dr-paradox-design/analog_neuron/docs/gate-A.md

# Gate A — schematic sign-off (2026-10-15)

**Result: PASS.** Every target spec is met at schematic level over all 45 PVT points
(5 process corners × −40 / 27 / 125 °C × 1.62 / 1.8 / 1.98 V). Layout may start.

Design: `spice/neuron/neuron_core.spice` (with `vi_conv.spice`, `ota5p.spice`,
`spice/bias/bias_ref.spice`). Evidence tables: `verif/sim/gate-A/`. Each one is the console
output of `scripts/sim.py`, regenerated by the command in the last column.

| Spec (CLAUDE.md) | Target | Result | Evidence | Command |
|---|---|---|---|---|
| Input range | 0.3 – 1.2 V | transfer verified over 0.3 – 1.2 V | `neuron_pvt.txt` | `scripts/sim.py spice/neuron/neuron_tb.cir --pvt --jobs 14` |
| Unit bias current | 1 – 5 µA | 1.13 – 3.89 µA (incl. R ±20 %) | `bias_pvt.txt` | `scripts/sim.py spice/bias/bias_tb.cir --pvt` |
| Bias start-up | every corner | 1 µs / 100 µs / quasi-static ramps and brown-out all settle to the same current (45/45) | `bias_startup_pvt.txt`, `bias_dcramp_pvt.txt` | `…/bias_startup_tb.cir --pvt`, `…/bias_dcramp_tb.cir --pvt` |
| Total power | < 100 µW | 37.7 – 78.3 µW; 98.2 µW worst at R −20 % (see note) | `neuron_pvt.txt`, `neuron_pvt_r_minus20.txt` | as above |
| MAC linearity | ≤ 5 % | INL ≤ 0.71 % (PVT), ≤ 0.76 % (R ±20 %), ≤ 0.82 % (MC) | `neuron_pvt*.txt`, `neuron_mc200.txt` | as above |
| Corners | TT/FF/SS/SF/FS, −40…125 °C, VDD ±10 % | 45/45 clean for every testbench | all | — |
| Mismatch: weight σ | < 2 – 3 % | slope σ 1.47 % (200 runs, tt_mm) | `neuron_mc200.txt` | `scripts/sim.py spice/neuron/neuron_tb.cir --mc 200 --corner tt_mm --jobs 14` |
| Stability (internal) | PM ≥ 60° | ≥ 71.7° at 45 PVT × 3 input levels | `vi_stab_pvt.txt` | `scripts/sim.py spice/neuron/vi_stab_tb.cir --pvt --jobs 12` |
| Area | 180 × 115 µm | ≈ 6.2k µm² of devices → ≈ 12–14k µm² with routing (estimate) | `docs/neuron-core.md` | `build/area/gen_all.tcl` |

Function delivered: **y = 2 · max(0, x − V_k)**, V_k = 0.326 · VDD (0.586 V at 1.8 V).
Slope over PVT 1.903 – 1.995; knee independent of temperature and process.

## Decisions taken at this gate

- **Output: raw node, no buffer.** Silicluster has not specified the output load. y has
  ≈ 300 kΩ output impedance and must be measured with ≥ 10 MΩ (≈ 2.8 % gain loss; linearity is
  unaffected). If Silicluster later specifies a heavier load, a buffer needs a core power cut first.
- **Core power kept as verified.** The 98.2 µW case combines the hottest, highest-supply corner
  with an assumed −20 % xhigh_po sheet resistance; SkyWater lists xhigh_po e-test specs as TBD.

## Carried into layout

- Mirror matching sets the weight σ: MF / XWS / XWK in common-centroid with dummies.
- R_in, R_k, R_out from interdigitated unit segments (also required by the 115 µm height).
- Cc MIM capacitors (metal 3–4) need gaps in the M4 power grid.
- Post-layout: re-check phase margin with extracted parasitics (pre-layout margin 71.7°).
- Simulation pitfall: the xhigh_po model allows spurious kV solutions; `neuron_tb.cir` detects
  and retries them automatically (see `docs/neuron-core.md`).
