dr-paradox-design/analog_neuron/docs/img/block-diagram-philosophy.md

# Conductive Silence

*A visual philosophy for drawings of things that flow but cannot be seen.*

Conductive Silence treats the invisible as something that can be counted. A flow is never a single
arrow; it is a bundle of hairlines laid side by side, and the number of strands is the quantity.
When a flow is amplified, the bundle visibly thickens strand by strand; when two flows meet and
cancel, strands end. Meaning is carried by accumulation and subtraction of identical marks, drawn
with the patience of an engraver: each line the same weight, each gap the same width, the whole
reading as one calm texture from afar and as an exact ledger up close. Nothing is exaggerated to be
understood — the drawing rewards the viewer who slows down.

Space is a dark, quiet field, deep enough that a hairline glows. Forms are few and perfect: true
circles for points where things meet, softened rectangles for places where something transforms, and
nothing ornamental between them. Elements align to an unseen grid of strict horizontals; diagonals
appear only where flows must converge, and then as long, unhurried curves. Generous negative space
is structural, not leftover — it isolates each event so the eye moves through the plate in the order
the flow does. The composition must feel meticulously crafted, every spacing resolved by countless
small corrections until nothing can move.

Colour is a code, not a mood. A neutral grey carries structure; two or three restrained accents —
cool blue, warm amber, quiet green — identify distinct flows and never mix. Saturation stays low so
that the accents read as light on dark rather than paint. Where flows meet, colour does not blend;
one simply ends and another begins, so the palette itself states what is conserved and what is
consumed. The calibration of these few hues should look like the product of deep expertise:
balanced against each other and against the darkness with painstaking attention.

Inside each form sits a miniature: a row of identical ticks for repeated units, a small glyph for a
behaviour, a ratio expressed as stacked segments. These are the plate's quiet evidence — tiny,
exact, and only legible to those who look closely. Scale moves in deliberate steps: the field, the
flows, the forms, the miniatures, and finally the text, each an order of magnitude finer than the
last.

Typography is clinical and sparse. Labels are thin, uppercase and widely tracked, set small beneath
the forms they name; indices and coordinates are monospaced and smaller still, like the margins of a
scientific plate. One single phrase — a law, an equation, a name — may be set larger in a refined
serif italic as the plate's anchor. Text never explains; it only names what the drawing already
shows. Margins are generous and every element stands clear of every other. The finished plate should
read as master-level execution: an artifact from an imaginary discipline that has spent a lifetime
learning to draw silence carrying current.
