dr-paradox-design/analog_neuron/docs/img/transfer.png

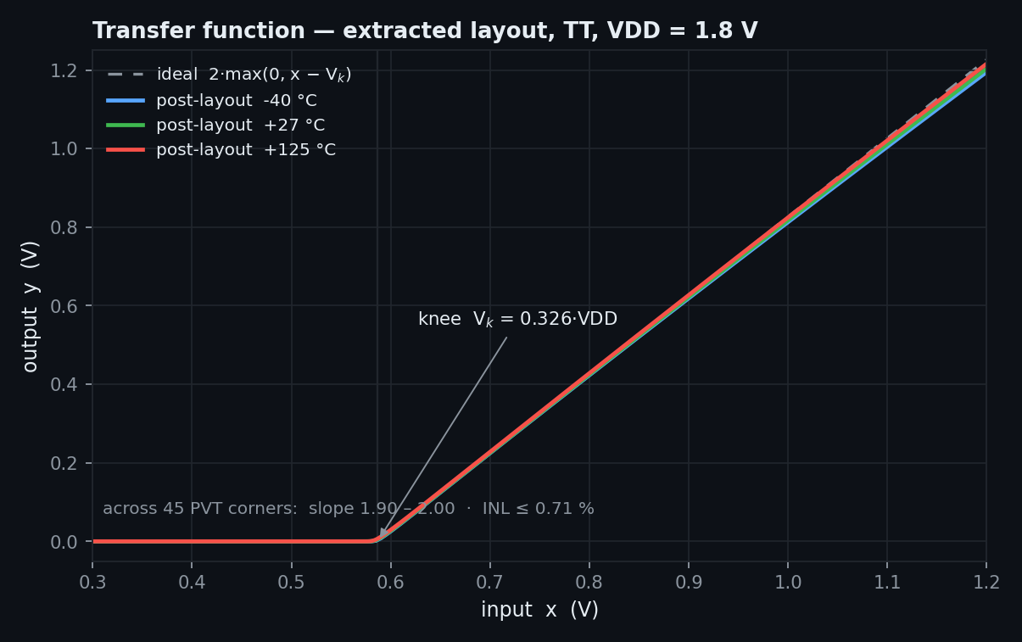
docs/img/transfer.png
