dr-paradox-design/analog_neuron/(commit log)

2026-10-11 Add device characterisation testbench (Vgs, gm/Id vs L)
    nfet/pfet_01v8 at W=2um, |Vds|=0.9V, L sweep 0.5-8um; templated
    for corner/temp/VDD via scripts/sim.py.
2026-10-11 Bias reference: device characterisation and beta-multiplier with start-up
    - spice/char/devchar_tb.cir: nfet/pfet_01v8 Vgs and gm/Id vs L at 1/2/5 uA
    - spice/bias/bias_ref.spice: beta-multiplier (K=4, xhigh_po R) + start-up
    - start-up fixed: weaker pull-up and stronger MS2 so MS3 turns fully off
    - R sweep and operating-point debug testbenches
2026-10-11 Bias reference: fix false low-current state, add PVT testbench
    - MS3 start-up kick now injects VDD -> VN: at -40 C / 1.62 V the PMOS gate
    line VP drops below VN, so the old VP -> VN kick conducted backwards and
    held the loop at ~0.3 uA
    - weaker pull-up (2 x L=40) and stronger MS2 (W=16) so ST < 10 mV everywhere
    - bias_tb.cir: 45-point PVT with R nominal/-20%/+20% (PDK corners do not
    vary xhigh_po sheet resistance)
    - sim.py: --corners option for custom corner lists (e.g. ss_hh)
    - result: 1.13-3.89 uA over PVT and R+-20%, start-up fully off
2026-10-11 Docs: bias reference design note, ADR findings; add start-up testbench
    - docs/bias-reference.md: circuit, sizing, design choices, PVT results
    - ADR-001: findings (pfet Vt headroom, xhigh_po not in R corners, sf/fs
    naming, weak-inversion bias, start-up false state, PTAT bias term) and
    new open question on threshold accuracy over temperature
    - spice/bias/bias_startup_tb.cir: 1 us / 100 us / 5 ms ramps + brown-out
2026-10-11 OTA: 5T PMOS-input OTA for the V->I converters; ADR records owner decisions
    - spice/neuron/ota5p.spice: PMOS pair in its own n-well (tied to tail),
    NMOS mirror load, tail = PMOS copy of the bias reference
    - ota5p_tb.cir: open-loop AC at 0.25 V input CM: ~38 dB, UGF 5.2 MHz into
    0.5 pF, ~87 deg phase margin, systematic offset ~3.5 mV (5 corners)
    - ADR-001: accepted; owner decisions (ReLU, w=2 with knee at ~0.6 V, ~200k
    input impedance OK, VDD-divider reference) and refined knee-replica
    signal path
2026-10-11 Bias start-up verified at 45 PVT points; V->I converter with compensation
    Bias reference start-up (all 45 PVT points, 5 profiles each):
    - 1 us ramp, 100 us ramp, brown-out to 0.8 V, quasi-static DC up/down
    all settle to the same current (0.000 % spread); start < 3 us,
    turn-on at VDD 0.91-1.22 V, ST <= 7.4 mV
    - 5 ms transient ramp replaced by a DC sweep: ngspice stalls on the
    femtoamp start-up nodes while every device is still off
    V->I converter (OTA + R_in + MF, I0 = Iref/2 keeps MF out of deep
    subthreshold):
    - Miller Cc 0.45 pF + nulling Rz ~49k: phase margin 79-109 deg at TT
    (was 15 deg at x = 0.3 V with 0.2 pF and no Rz)
    - DC: endpoint INL <= 0.054 % over 0.3-1.2 V at all 5 corne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
2026-10-11 Neuron core: knee-replica ReLU neuron, y = 2(R_out/R_in) max(0, x - V_k)
    - neuron_core.spice: bias ref, xhigh_po unit-resistor divider (Ra:Rb:Rc:R_k
    = 9:4:3:7 -> VREF 0.142 VDD, VK 0.331 VDD), signal + knee V->I
    converters, x2 NMOS weight mirrors, PMOS knee flip, PMOS ReLU diode and
    output copy into R_out (7 units)
    - divider fix: R_k current returns to VSS through MF_k, not into VREF
    - neuron_tb.cir: x ramp 0.29->1.21 V over 2 ms (DC sweep in x needed
    repeated gmin rescues); 5 corners @27C/1.8V: INL 0.38-0.42 %, error vs
    ideal <= 2.2 %, slope 1.96-1.97, knee 0.582 V, peak 55.6 uW, y < 1 uV
    below the knee
    - V->I loop stability, variant D (0.45 pF + ~49k Rz, I0 = Iref/2): phase
    m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
2026-10-11 Monte Carlo support; robust neuron testbench (WIP: MC outliers open)
    sim.py:
    - --mc N (seeds 1..N via @SEED@, use a *_mm corner) and --jobs N
    (parallel ngspice, one thread each); prints mean/sigma per result
    - a testbench result 'sane = 0' marks the run as failed
    neuron_tb.cir:
    - the PDK xhigh_po model has negative voltage coefficients, so R crosses
    zero near |V| ~ 1 kV and Newton can lock onto spurious kV solutions
    (~3 % of mismatch seeds, either start method)
    - now: power-up start (uic); if a key node leaves the physical range,
    the same seed is re-run from a nodeset operating point at full VDD;
    stand-in pad ESD diodes on y; RESULT sane/method reported
    - forced-retry check: both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
2026-10-11 Neuron MC: wider physical-range check; parametrise mirror/I0/OTA sizes
    - neuron_tb.cir: retry check now covers 13 internal nodes incl. the
    Rz-Cc nodes (held only by an xhigh_po resistor at DC) and requires a
    positive supply current; seed 52 (Rz-Cc node at ~500 kV, previously
    passed as 'dead output') is now caught and re-run: slope 1.95
    - neuron_core / vi_conv: mf_w/mf_l (MF and x2 weight copies), i0_w/i0_l,
    ota_in_*/ota_ld_* are parameters; defaults unchanged (TT result
    identical)
    Mismatch status (200-run MC, tt_mm, old sizes): slope sigma 2.77 %,
    knee sigma 48 mV -> device upsizing study next
2026-10-15 Add MC comparison script; global resistor-scale parameter in neuron core
    - scripts/mc_compare.py: slope/knee mean and sigma, INL worst case,
    peak power and retry count per Monte Carlo result set
    - neuron_core: rscale scales every xhigh_po resistor (divider, R_in,
    R_out, bias reference, Rz) to model sheet-resistance spread, which the
    PDK corners do not vary; rscale=1 reproduces the previous TT result
    exactly (slope 1.9656, INL 0.402 %)
    Area estimate from Magic-generated devices: ~4,850 um2 of devices
    (guard rings included) vs 20,700 um2 budget -> ~10-12k um2 with routing;
    no area risk so far (output buffer still TBD)
2026-10-15 Neuron sizing for mismatch: 4x mirror/I0/flip area, recompensated V->I
    MC study (100 runs each, tt_mm 27C 1.8V):
    A original sizing slope sigma 2.81 % knee sigma 49.7 mV
    B weight mirror 16/4 slope sigma 1.33 % knee sigma 31.4 mV
    C B + flip 32/4, I0 16/4 slope sigma 1.36 % knee sigma 23.7 mV <- chosen
    D C + 4x OTA devices slope sigma 1.36 % knee sigma 22.6 mV
    Same W/L everywhere, so operating points are unchanged.
    The 4x mirror gate area loads the V->I compensation node: worst phase
    margin fell 75.3 -> 48.8 deg. Cc 0.45 -> 0.80 pF (20x20 MIM), Rz 17 ->
    25 um (~72k): PM >= 71.7 deg at all 45 PVT points x 3 input levels
    (crossover 2.0-5.2 MHz). Rz follows rsc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
2026-10-15 Docs: neuron core design note with final sizing and sign-off results
    - 45 PVT: slope 1.903-1.995, knee = 0.326 VDD (flat over T/process),
    INL <= 0.71 %, power 37.8-78.3 uW
    - R -20/+20 % (all xhigh_po), 45 PVT each: slope/knee unchanged,
    INL <= 0.76 %; power up to 98.1 uW at R -20 %, 125 C, 1.98 V
    - 200-run MC: slope sigma 1.47 % (spec < 2-3 %), knee sigma 22.3 mV
    - V->I phase margin >= 71.7 deg at 45 PVT x 3 inputs
    - output loading: 10 Mohm -2.8 % gain, 1 Mohm -22 %; INL unaffected
    - supply-current breakdown at the worst power corner
    - SkyWater: xhigh_po e-test specs still TBD -> +-20 % is an assumption
2026-10-15 Gate A: schematic sign-off with evidence tables
    All target specs met at 45 PVT points: bias 1.13-3.89 uA, start-up at
    every corner, INL <= 0.81 % worst (spec 5 %), weight sigma 1.47 % (spec
    2-3 %), phase margin >= 71.7 deg, power 37.8-78.3 uW (98.1 uW at the
    pessimistic R -20 % corner).
    Owner decisions: raw output without buffer (Silicluster has not
    specified the load; measure with >= 10 Mohm), keep the verified core.
    verif/sim/gate-A/: sim.py console tables for every check; docs/gate-A.md
    lists the command that regenerates each one.
2026-10-15 Layout: Python .mag tooling and DRC/LVS-clean OTA block
    scripts/layout/maglib.py: devices generated by Magic's PDK generators
    (cached under deterministic names in mag/neuron/), terminal geometry
    parsed from the generated .mag; placement and routing written as .mag
    text on the 5 nm grid. Via/pad sizes from the sky130A Magic DRC deck.
    scripts/layout/router.py: channel routing - metal2 risers from each
    terminal, one metal3 track per net per channel.
    ota5p (13.5 x 24.5 um): tail, input pair in a shared T well, NMOS
    mirror; ports on metal3 at the left edge.
    - DRC (drc(full)): No errors found, DRC_COUNT 0
    - LVS: circuits match uniquely, no property errors
    lvs.sh now prints an explicit verdict: n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
2026-10-15 Layout: bias reference block DRC/LVS clean; router vertical constraints
    bias_ref (55 x 54 um): NMOS row M2a M2b M1 M2c M2d (M1 at the centroid
    of the 4x device) | MS2 MS3 | R1; PMOS row M3 M4 | MS1A/MS1B.
    - LVS: 9 devices, 7 nets, match uniquely, no property errors
    Router fixes found by LVS (DRC cannot see same-layer merges):
    - vertical constraints: a riser from above and one from below within
    0.6 um force the upper net onto the higher track (VN/VP short)
    - same-side risers of different nets must be >= 0.465 um apart; the
    router now refuses closer ones
    - MS2 (L=0.5): flipped so its gate goes to the bottom channel, source
    strapped to its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
2026-10-15 Layout: neuron_core top level DRC and LVS clean
    neuron_core (about 162 x 105 um extent, inside 180 x 115):
    - left column: OTA_S, OTA_K, BIAS as LVS-verified macros, connected
    through metal3 port extensions to private riser columns
    - row 1: I0_S | WK1 WS1 MS MK WS2 WK2 | I0_K | Rz array (2+2 units)
    - row 2: 37-unit xhigh_po array (S/K/O in mirrored S-K-O/O-K-S
    triplets, divider units at both ends, dummy ends) | spines | Cc_S Cc_K
    - row 3: PMOS flipped, ABBA: PR1 PR2 PK1 PK2 PK2 PK1 PR2 PR1 (each W=32
    device as 2 x W=16)
    - MIM caps: bottom plate via a metal3 tab, top plate via a metal4 tab and
    via3 placed > 1.34 um from the capacitor
    Verification:
    - DRC (drc(full)): No errors found, D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
2026-10-15 Post-layout verification: parasitic extraction, PVT transfer and loop stability
    - scripts/pex.tcl: flat extraction with capacitance to substrate and
    coupling (506 parasitic C, ~495 fF); nets are named by router labels
    - 45 PVT post-layout transfer: slope 1.9036-1.9949, knee 0.525-0.644 V,
    INL <= 0.70 %, power 37.6-78.0 uW (schematic: same within 0.1 %)
    - loop stability by Middlebrook double injection at the OTA outputs
    (cuts every feedback path, incl. the knee loop's second path through
    the shared VREF divider that a single input cut cannot capture):
    signal loop PM >= 62.5 deg, knee loop PM >= 85.8 deg at all 45 PVT
    points x 3 input levels; validated against the simple input cut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
2026-10-15 Top cell analog_neuron with power grid; GDS exported
    analog_neuron (180 x 115 um, FIXED_BBOX): neuron_core + power grid
    - metal5 rails: VSS bottom, VDD top (VDD/VSS pins)
    - metal4 straps every 10 um, alternating VSS/VDD, via4 to their rail,
    via3 onto the core's VDD/VSS metal3 tracks (24); straps split around
    the MIM capacitors (metal4 top plates, 1 um keep-out)
    - X, Y pins: core metal3 tracks extended to the right edge
    - LVS: match uniquely, no property errors; core keeps exactly its four
    ports (no shorts from top-level metal into core nets)
    gds/analog_neuron.gds: top cell analog_neuron, bbox 0,0 - 180,115 um
    (read back with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
2026-10-15 Gate B sign-off, layout notes and submission package
    - docs/gate-B.md: DRC 0 and LVS PASS for every cell and the top;
    post-layout 45-PVT transfer and loop stability vs schematic; checks on
    the checks; what was not run (antenna check, xschem)
    - docs/layout.md: generation flow, routing method, floorplan, pins
    - submit/: analog_neuron.gds (180 x 115 um), LVS reference netlist,
    README with function, pins, power and verification summary
    - ADR-001 action items 11-15 done; resistance figures made consistent
    (unit = 43.4 kOhm, R_in = R_out ~ 300 kOhm)
2026-10-15 README: replace the Mermaid chart with a designed block-diagram plate
    docs/img/block-diagram.png (scripts/plot_block_diagram.py): currents drawn
    as strand bundles whose count is the current - the x2 mirrors double
    their bundle, the knee bundle is subtracted at the sum and only the
    excess reaches the output; resistor forms show their real unit counts
    (7 for R_in/R_out, divider 9:4:3). Renders everywhere, unlike Mermaid.
    Design notes: docs/img/block-diagram-philosophy.md.
2026-10-19 Silicluster v3 submission package per the call (section 10)
    - submit/analog_neuron.v: interface-only Verilog module (VDD, VSS,
    input X, output Y), checked with iverilog
    - submit/analog_neuron_validation.pdf (7 pages): summary vs targets,
    interface, circuit, setup, transfer, all 45 PVT points, Monte Carlo,
    bias/start-up, post-layout stability, DRC/LVS evidence, reproduction,
    known limitations; generated by scripts/validation_report.py from the
    result files of the actual runs
    - scripts/make_submission.py builds submit/analog_neuron_silicluster_v3.zip
    (GDS, 18 .mag cells, Verilog, testbenches + netlists + runner,
    extracted netlists, PDF, DRC/LVS logs, result tables); the zip is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
    [analog_neuron.v]
2026-10-19 Cross-verification of the submitted GDS; pin-label fix; safe rounding
    Independent checks on the GDS itself (verif/crossverify/SUMMARY.md):
    - KLayout PDK decks: sky130A_mr (FEOL+BEOL+off-grid) 0, pin-label 0,
    zero-area 0
    - Magic DRC of the GDS read back: 0; LVS of the GDS: match uniquely,
    0 property errors; antenna check: no violations
    - GDS regenerated from the .mag cells: layer-by-layer XOR identical
    - pins, bounding box and M4-vertical/M5-horizontal grid read from the GDS
    Fixed: three metal3 port labels reached 0.1 um past their track end
    (pin shapes not over drawing: Magic GDS read-back DRC showed 7 met3.1
    errors, the PDK pin-label deck 3). Router now keeps port labels inside
    the tra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
2026-10-20 README: verification and submission sections, status line, updated badges
    - badges: DRC Magic + KLayout, antenna, Silicluster v3 submission ready
    - status: schematic sign-off -> layout sign-off -> GDS cross-verified ->
    submission (deadline 31 Oct 2026)
    - results: phase margin for both loops (>= 62.5 / >= 85.7 deg)
    - new Verification table (Magic and KLayout DRC, LVS of cells and GDS,
    antenna, pin-label/zero-area, GDS vs .mag XOR) with evidence links
    - new Submission package table mapped to the call (section 10)
    - reproduce: post-layout sims, GDS export, KLayout DRC, report and zip
2026-10-20 README: theory of operation with equations
    Replaces the short 'How it works' bullets: neuron model mapping
    (w = 2, b = -2 Vk), ratiometric divider (VREF = 21/148 VDD,
    Vk = 49/148 VDD), V-to-I converters, weight and KCL summation
    (VREF and I0 cancel), ReLU from a PMOS diode, I-to-V output,
    PVT cancellation table, beta-multiplier bias (n UT ln K / R1),
    accuracy (Pelgrom mismatch, INL definition, systematic slope),
    stability (Miller + nulling resistor, knee loop's second path,
    Middlebrook), output loading.
2026-10-20 README: animated neuron, stat tiles, collapsible reference sections
    - docs/img/neuron.gif (scripts/animate_neuron.py): x sweeps 0.3 -> 1.2 V;
    current strands flow (one strand ~ 0.5 uA), the signal bundle grows,
    the knee bundle is fixed and output current appears only above the
    knee, next to the post-layout transfer curve with the operating point
    - stat tiles under the hero: INL <= 0.71 %, weight sigma 1.47 %,
    PM >= 62.5 deg, power <= 78 uW (98 uW at R -20 %)
    - 'See it work' section with the animation; the multi-temperature
    transfer plot moves to Results
    - repository layout and reproduction commands folded into <details>
2026-10-20 Neuron animation: strands flow input to output (dash offset was moving them backwards)
2026-10-20 Neuron animation: slower dot-like flow so the input-to-output direction reads unambiguously; seamless loop
2026-10-20 xschem schematics of ota5p, bias_ref, vi_conv and neuron_core, LVS-checked against the SPICE netlists; restyled SVG exports
    [bias_ref.sch, neuron_core.sch, ota5p.sch, vi_conv.sch]
2026-10-20 README: xschem schematic screenshots (neuron_core, V-to-I, OTA, bias); schematics respaced, still LVS-matched
    [bias_ref.sch, neuron_core.sch, vi_conv.sch]
2026-10-20 Full flat transistor-level xschem schematic of the neuron (39 devices, LVS-matched to the design) replaces the block view in the README
    [analog_neuron.sch]
